dvjcodec/SCG-ATC-722.6/Win_app_mb_w203_sample_settings.txt

#Seaside File
#Thu Sep 10 15:14:27 CEST 2020
TRIGGER.WHEEL.TEETH=58
TRUE.POWER=true
RPM.SPEED=false
CURRENT.EVAL.GEAR=0
REAR.DIFF.TEETH=23
TCC.LOCK=true
MAX.RPM=7000
MANUAL=true
CURRENT.LAMDA=0
ADAPTIVE=false
CURRENT.SLIP=0.0
STALL.SPEED=2200
EXHAUST.PRESS=false
BOOST.MAX=700
CURRENT.RPM=0
W124SPEEDO=false
FUEL.MAX.RPM=2000
BOOST=false
TPS=true
FUEL.PUMP=false
CURRENT.EX.PRES=0
FUEL.USED=0
BOOST.DROP=50
DATA.LOGGER=true
ATF.TEMP=0
TIRE.INCHES=18
DIFF.RATIO=3.27
BOOST.SPRING=120
CURRENT.OIL.TEMP=0
NEXT.SHIFT.DELAY=1792
FIRST.TCC.GEAR=5
DIFF.SPEED=false
BATTERY=0
DEBUG=false
MAX.SLIP=0.50
CURRENT.LOAD=0
BATTERY.LIMIT=14097
W124RPM=false
STICK.CONTROL=false
FUEL.USED.AVG=0
TIRE.PROFILE=40
BATTERY.MONITOR=true
RADIO.ENABLE=false
BOOST.LIMIT=false
CURRENT.TPS=0
FULL.AUTO=false
CURRENT.RATIO=0.0
CURRENT.PRESS.DIFF=0.0
CURRENT.SPEED=0
CURRENT.BOOST.LIMIT=0
TIRE.WIDTH=225
TPS.AGRE=2
EVAL.GEAR=false
